shhoel/FPGA-Real-Time-Background-Subtraction-OV7670-DE2-115/Images/Setup.jpg

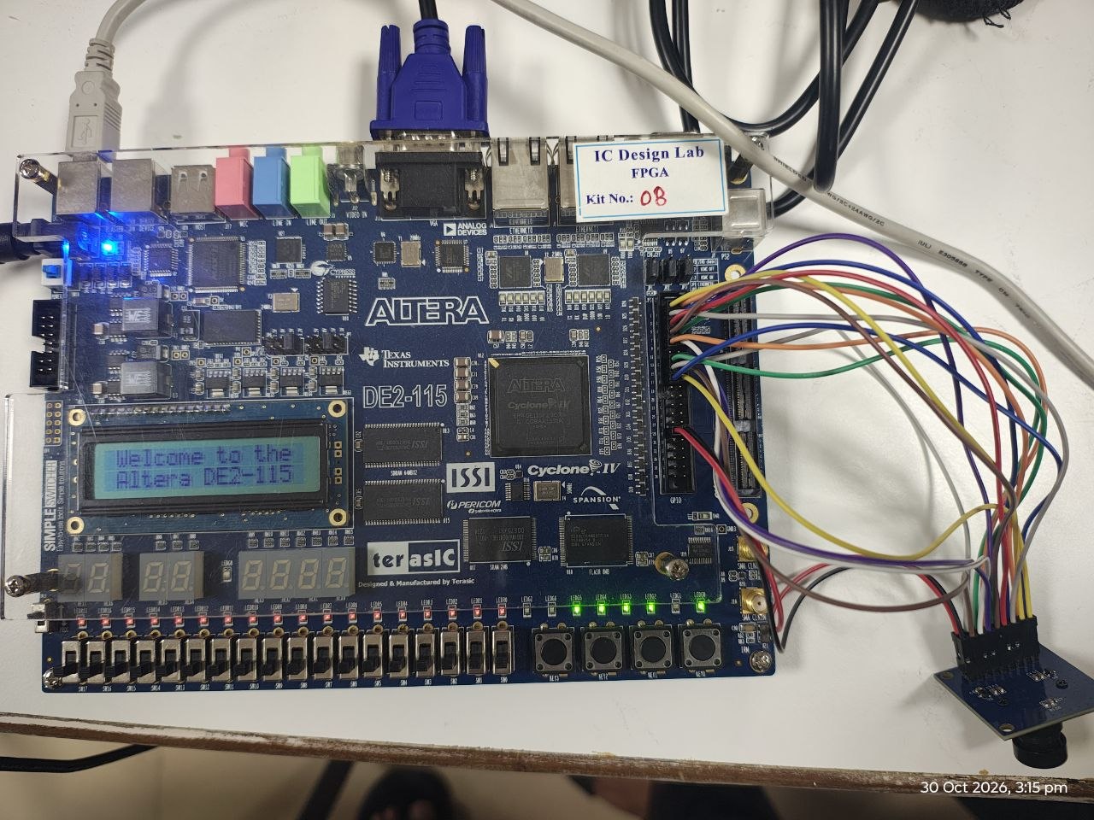
Images/Setup.jpg
