shhoel/FPGA-Real-Time-Background-Subtraction-OV7670-DE2-115/Images/Live Image.jpg

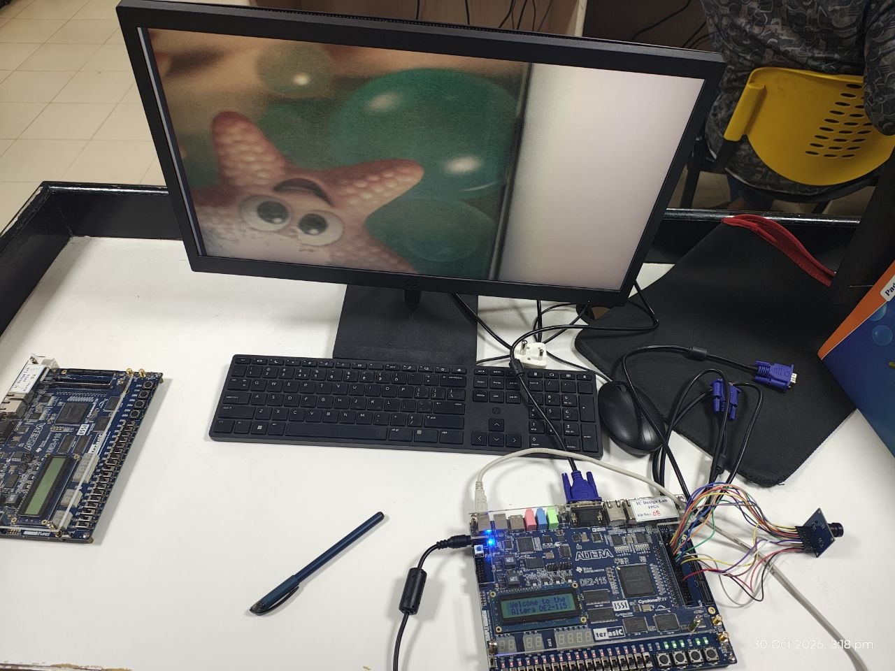
Images/Live Image.jpg
