shhoel/FPGA-Real-Time-Background-Subtraction-OV7670-DE2-115/README.md

# FPGA-Based Real-Time Background Subtraction Using OV7670 and DE2-115

## Overview

This project implements a **real-time video background subtraction system on FPGA** using an **OV7670 camera module**, **Terasic DE2-115 development board**, and **VGA monitor**.

The OV7670 camera provides a live RGB565 video stream. The FPGA captures the camera data, converts RGB565 pixels to RGB444, reduces the image resolution from 640×480 to 320×240, stores both live and reference-background frames, performs pixel-wise foreground detection, removes noise using a 3×3 majority filter, and displays the processed result on a VGA monitor.

The system supports:

- Normal live video
- Background subtraction
- Original-color foreground with black background
- Binary white foreground mask
- Adjustable foreground threshold
- VGA diagnostic color bars
- Camera/debug status LEDs

---

# Hardware Used

- Terasic DE2-115 FPGA Development Board
- Intel/Altera Cyclone IV E FPGA
- FPGA Device: `EP4CE115F29C7`
- OV7670 CMOS Camera Module
- VGA Monitor
- VGA Cable
- Jumper Wires

---

# Software Used

- Intel Quartus Prime
- Verilog HDL

---

# System Flow

```text
OV7670 Camera
      |
      v
Camera Configuration
      |
      v
8-bit Camera Data Capture
      |
      v
Two Bytes Combined
      |
      v
RGB565 Pixel
      |
      v
RGB565 to RGB444 Conversion
      |
      v
640x480 to 320x240 Downsampling
      |
      +----------------------+
      |                      |
      v                      v
Live Frame Buffer      Background Frame Buffer
      |                      |
      +----------+-----------+
                 |
                 v
        Pixel-wise Comparison
                 |
                 v
       Luminance + RGB Difference
                 |
                 v
          Foreground Score
                 |
                 v
             Threshold
                 |
                 v
        Raw Foreground Mask
                 |
                 v
        3x3 Majority Filter
                 |
                 v
         Filtered Mask Buffer
                 |
                 v
          Final Pixel Selection
                 |
                 v
             RGB Module
                 |
                 v
            VGA Monitor
```

---

# Main Modules

## 1. `bg_subtraction_top.v`

This is the **top-level integration module**.

Responsibilities:

- Receives the 50 MHz DE2-115 clock
- Generates a 25 MHz VGA-side clock
- Instantiates all project modules
- Synchronizes push buttons and switches
- Controls OV7670 configuration
- Controls background capture
- Reads live and background pixels
- Calculates luminance and RGB differences
- Generates the foreground score
- Performs threshold comparison
- Selects live video, foreground output, binary mask, or VGA test pattern
- Controls debug LEDs
- Sends the final RGB pixel to the VGA interface

The actual background-subtraction decision is implemented in this module.

---

## 2. `ov7670_controller.v`

This module controls OV7670 initialization.

Responsibilities:

- Generates the camera XCLK
- Keeps the camera powered and out of reset
- Receives camera register commands from `ov7670_registers.v`
- Sends commands through `i2c_sender.v`
- Advances to the next camera register
- Indicates when configuration is complete

The camera XCLK is generated by dividing the 50 MHz input clock by two.

```text
50 MHz / 2 = 25 MHz
```

---

## 3. `ov7670_registers.v`

This module acts like an **internal ROM / lookup table** containing the OV7670 initialization sequence.

Each 16-bit command contains:

```text
[15:8] = OV7670 register address
[7:0]  = value written to the register
```

For example:

```text
16'h4010
```

means:

```text
Register address = 0x40
Register value   = 0x10
```

The register sequence configures:

- Camera reset
- RGB output mode
- RGB565 format
- Clock settings
- Automatic gain control
- Color conversion matrix
- Gamma processing
- Horizontal image window
- Vertical image window
- Mirror/flip configuration

The final working color matrix used in this project is:

```text
4F40
5034
510C
5217
5329
5440
581E
```

---

## 4. `i2c_sender.v`

This module performs SCCB/I²C-like communication with the OV7670 camera.

It sends:

```text
Camera Device Address
Register Address
Register Value
```

using:

```text
SIOC
SIOD
```

The OV7670 write ID used in the controller is:

```text
0x42
```

A simple way to understand the configuration chain is:

```text
ov7670_registers = WHAT to send
i2c_sender       = HOW to send it
ov7670_controller = WHEN to send it
```

---

## 5. `ov7670_capture_bg.v`

This module is responsible for camera pixel capture and background-frame capture.

Responsibilities:

- Samples camera data, HREF and VSYNC on the falling edge of PCLK
- Processes the captured values on the rising edge of PCLK
- Combines two 8-bit camera bytes into one RGB565 pixel
- Supports optional RGB565 byte swapping
- Converts RGB565 to RGB444
- Reduces resolution from 640×480 to 320×240
- Continuously writes the live frame buffer
- Captures one full background frame after KEY1 is pressed
- Generates background busy and background valid status signals

### PCLK Timing Method

Camera signals are sampled on the falling edge:

```text
Falling PCLK
→ sample CAM_D, HREF and VSYNC
```

Then processed on the rising edge:

```text
Rising PCLK
→ assemble and write the pixel
```

This provides approximately half a PCLK period for camera signals to settle and helped remove horizontal tearing in the video.

---

# RGB565 to RGB444 Conversion

The OV7670 produces RGB565:

```text
RRRRR GGGGGG BBBBB
```

This uses:

```text
Red   = 5 bits
Green = 6 bits
Blue  = 5 bits
Total = 16 bits
```

The project converts this to RGB444:

```text
RRRR GGGG BBBB
```

which uses:

```text
Red   = 4 bits
Green = 4 bits
Blue  = 4 bits
Total = 12 bits
```

The conversion used in the capture module is:

```verilog
wire [11:0] pixel444 = {
    pixel565[15:12],
    pixel565[10:7],
    pixel565[4:1]
};
```

### Why RGB444?

RGB444 is used because:

- It reduces frame-buffer memory usage
- It simplifies arithmetic
- Background subtraction does not require full RGB565 precision
- All three color channels have equal 4-bit widths

For one 320×240 frame:

```text
320 × 240 = 76,800 pixels
```

RGB565 memory:

```text
76,800 × 16 = 1,228,800 bits
```

RGB444 memory:

```text
76,800 × 12 = 921,600 bits
```

Therefore RGB444 saves approximately 25% of pixel-storage memory.

---

# Resolution Reduction

The incoming camera frame is:

```text
640 × 480
```

The FPGA stores and processes:

```text
320 × 240
```

This is called:

**2× spatial downsampling**

or

**VGA to QVGA resolution reduction**

The capture module keeps:

- Every second pixel horizontally
- Every second input line vertically

The relevant condition is:

```verilog
if (!x_pixel[0] && !y_line[0])
```

This means only even x and even y positions are stored.

Therefore:

```text
640 / 2 = 320
480 / 2 = 240
```

The number of pixels reduces from:

```text
640 × 480 = 307,200 pixels
```

to:

```text
320 × 240 = 76,800 pixels
```

This reduces the number of stored and processed pixels by a factor of four.

---

# Frame Buffers

Two RGB444 frame buffers are used.

## Live Frame Buffer

The live frame buffer is continuously updated with the newest camera frame.

It does not store every video frame permanently.

At every new frame:

```text
write address resets to 0
```

and the new frame overwrites the previous frame.

Therefore memory usage remains constant.

---

## Background Frame Buffer

The background frame buffer stores one fixed reference frame.

When `KEY1` is pressed:

```text
Background request
→ wait for next VSYNC
→ capture one complete frame
→ store it as background
```

The stored background remains unchanged until another background capture is requested.

---

# Frame Buffer Size

Resolution:

```text
320 × 240
```

Total locations:

```text
76,800
```

Each RGB444 pixel:

```text
12 bits
```

The frame-buffer address uses:

```text
17 bits
```

because:

```text
2^16 = 65,536  -> not enough

2^17 = 131,072 -> enough
```

---

# VGA Timing

The `vga_timing.v` module generates approximately:

```text
640 × 480 @ 60 Hz
```

using a 25 MHz pixel clock.

Horizontal timing:

```text
Active      = 640
Front Porch = 16
Sync        = 96
Back Porch  = 48
Total       = 800
```

Vertical timing:

```text
Active      = 480
Front Porch = 10
Sync        = 2
Back Porch  = 33
Total       = 525
```

---

# 320×240 to 640×480 Display

The stored video is 320×240 but the VGA display is 640×480.

The source coordinates are calculated using:

```verilog
wire [8:0] xs = h[9:1];
wire [7:0] ys = v[8:1];
```

This is equivalent to:

```text
source_x = VGA_x / 2
source_y = VGA_y / 2
```

Therefore each source pixel is displayed as a 2×2 VGA block.

---

# Frame Buffer Address Calculation

The RAM address is:

```text
address = y × 320 + x
```

Instead of using a multiplier:

```text
320 = 256 + 64
```

Therefore:

```text
y × 320
=
(y << 8) + (y << 6)
```

The code uses shift/concatenation and addition to implement this efficiently.

---

# Background Subtraction Algorithm

Each live RGB444 pixel is separated into:

```text
Rlive
Glive
Blive
```

The corresponding background pixel is separated into:

```text
Rbackground
Gbackground
Bbackground
```

---

## Luminance Calculation

A grayscale-like luminance value is calculated as:

```text
Y = (R + 2G + B) / 4
```

This does not convert the displayed image to grayscale.

The image remains RGB.

The luminance is only used internally for foreground detection.

---

## Difference Calculation

The FPGA calculates:

```text
dy = |Ylive - Ybackground|

dr = |Rlive - Rbackground|

dg = |Glive - Gbackground|

db = |Blive - Bbackground|
```

Then:

```text
max_rgb = max(dr, dg, db)
```

---

# Foreground Score

The foreground score is:

```text
foreground_score = 2 × dy + max_rgb
```

This gives more importance to luminance change while still considering color change.

---

# Threshold

The pixel is classified as foreground when:

```text
foreground_score > threshold
```

The final default threshold is:

```text
3
```

when:

```text
SW8:SW3 = 000000
```

If `SW8:SW3` is non-zero, the switch value becomes the threshold.

### Threshold Effect

Lower threshold:

```text
More sensitive
More foreground detected
More possible noise
```

Higher threshold:

```text
Less sensitive
Cleaner background
Possible loss of foreground regions
```

---

# Raw Foreground Mask

After thresholding:

```text
1 = foreground
0 = background
```

This produces a 1-bit binary mask called:

```text
foreground_raw
```

---

# 3×3 Majority Filter

The raw foreground mask may contain isolated noisy pixels.

The `mask_filter_3x3.v` module examines a 3×3 neighborhood:

```text
P1 P2 P3
P4 P5 P6
P7 P8 P9
```

The number of foreground pixels is counted.

The final implementation uses:

```text
4-out-of-9 majority rule
```

If at least four pixels are foreground:

```text
output = foreground
```

otherwise:

```text
output = background
```

The final code uses:

```verilog
out_mask <= (ones >= 4'd4);
```

This removes isolated noise while preserving foreground regions better than a stricter 5-out-of-9 rule.

---

# Mask Buffer

The filtered mask is stored in `mask_buffer.v`.

Each location requires only:

```text
1 bit
```

because:

```text
0 = background
1 = foreground
```

Mask resolution:

```text
320 × 240
```

---

# Final Pixel Selection

The final video output depends on the switches.

## Normal Video

```text
SW0 = 0
```

Output:

```text
Live camera image
```

---

## Background Subtraction

```text
SW0 = 1
```

and a valid background must already exist.

Background pixels are output as:

```text
RGB444 = 12'h000
```

which is black.

---

## Original-Color Foreground

```text
SW0 = 1
SW1 = 0
```

Output:

```text
Foreground = original RGB color
Background = black
```

---

## Binary Mask

```text
SW0 = 1
SW1 = 1
```

Output:

```text
Foreground = white
Background = black
```

White is:

```text
12'hFFF
```

---

# VGA Test Pattern

```text
SW2 = 1
```

enables an internally generated VGA color-bar test pattern.

This allows the VGA output path to be tested independently of the camera.

The pattern includes:

- White
- Yellow
- Cyan
- Green
- Magenta
- Red
- Blue
- Gray

---

# RGB Output Module

The internal pixel format is RGB444:

```text
12 bits
```

The DE2-115 VGA interface uses:

```text
8 bits Red
8 bits Green
8 bits Blue
```

The `RGB.v` module expands each 4-bit color channel by repeating the nibble.

Example:

```text
4'b1010
```

becomes:

```text
8'b10101010
```

During VGA blanking:

```text
R = 0
G = 0
B = 0
```

---

# Camera Connections

## OV7670 to DE2-115 JP5

| OV7670 Pin | Function | JP5 Physical Pin | FPGA Pin |
|---|---|---:|---|
| D0 | Camera data bit 0 | 1 | AB22 |
| D1 | Camera data bit 1 | 2 | AC15 |
| D2 | Camera data bit 2 | 3 | AB21 |
| D3 | Camera data bit 3 | 4 | Y17 |
| D4 | Camera data bit 4 | 5 | AC21 |
| D5 | Camera data bit 5 | 6 | Y16 |
| D6 | Camera data bit 6 | 7 | AD21 |
| D7 | Camera data bit 7 | 8 | AE16 |
| PCLK | Pixel clock | 9 | AD15 |
| HREF | Horizontal reference | 10 | AE15 |
| VSYNC | Frame synchronization | 13 | AC19 |
| XCLK | Camera input clock | 14 | AF16 |
| SIOC / SCL | SCCB clock | 15 | AD19 |
| SIOD / SDA | SCCB data | 16 | AF15 |
| RESET | Camera reset | 17 | AF24 |
| PWDN | Camera power-down | 18 | AE21 |
| 3.3 V | Camera supply | 29 | Power |
| GND | Ground | 30 | Ground |

**Important:** The OV7670 module is powered using 3.3 V.

---

# Camera Signal Directions

Camera to FPGA:

```text
D0-D7
PCLK
HREF
VSYNC
```

FPGA to camera:

```text
XCLK
SIOC
RESET
PWDN
```

Bidirectional:

```text
SIOD
```

---

# Push Buttons

| Button | Function |
|---|---|
| KEY0 | Reset/reconfigure the OV7670 |
| KEY1 | Capture a new reference background |

---

# Switch Functions

| Switch | Function |
|---|---|
| SW0 | Background subtraction enable |
| SW1 | Original-color / white-mask selection |
| SW2 | VGA test-pattern enable |
| SW8:SW3 | Foreground threshold |
| SW9 | RGB565 byte-order selection |

Final recommended setup:

```text
SW9 = 0
SW8:SW3 = 000000
```

which uses the default threshold of 3.

---

# Debug LEDs

| LED | Function |
|---|---|
| LEDG0 | OV7670 configuration complete |
| LEDG1 | Valid background stored |
| LEDG2 | PCLK activity |
| LEDG3 | HREF activity |
| LEDG4 | VSYNC activity |
| LEDG5 | Camera data activity |
| LEDG6 | Background capture busy |
| LEDG7 | Background subtraction active |
| LEDG8 | Alternate RGB565 byte order selected |

---

# `sig_activity.v`

Camera timing signals change too quickly to observe directly on LEDs.

The `sig_activity` module:

1. Synchronizes the asynchronous signal
2. Detects a transition
3. Loads a hold counter
4. Keeps the LED ON for approximately 0.17 seconds

This allows fast camera signals to be visually checked.

---

# Bit Widths Used

| Signal / Data | Width | Reason |
|---|---:|---|
| `CAM_D` | 8 bits | OV7670 parallel data bus |
| RGB565 | 16 bits | 5R + 6G + 5B |
| RGB444 | 12 bits | 4R + 4G + 4B |
| Frame address | 17 bits | Required for 76,800 locations |
| Internal R/G/B | 4 bits each | RGB444 format |
| `src_x` | 9 bits | Must represent 0–319 |
| `src_y` | 8 bits | Must represent 0–239 |
| Luminance sum | 6 bits | Maximum value is 60 |
| RGB differences | 5 bits | Safe subtraction width |
| Foreground score | 7 bits | Prevents overflow during weighted addition |
| Threshold | 6 bits | Comes from six switches |
| Foreground mask | 1 bit | Foreground/background only |
| VGA R/G/B | 8 bits each | DE2-115 VGA interface |

---

# How to Run

1. Connect the OV7670 camera to JP5 using the pin mapping above.
2. Connect the DE2-115 board to a VGA monitor.
3. Open the Quartus project.
4. Select the device:

```text
EP4CE115F29C7
```

5. Compile the project.
6. Program the DE2-115 FPGA.
7. Set:

```text
SW9 = 0
SW8:SW3 = 000000
SW2 = 0
SW1 = 0
SW0 = 0
```

8. Verify that the normal camera image is visible.
9. Keep the camera stationary.
10. Ensure no foreground object/person is present.
11. Wait a few seconds for camera exposure to stabilize.
12. Press `KEY1` once.
13. Verify that `LEDG1` indicates a valid background.
14. Enter the camera view.
15. Set:

```text
SW0 = 1
```

16. The unchanged background should become black.
17. Foreground objects should remain visible.
18. Set:

```text
SW1 = 1
```

to display the binary white foreground mask.

---

# VGA Test Procedure

To test the VGA interface independently:

```text
SW2 = 1
```

The monitor should display the internal color-bar pattern.

Then return:

```text
SW2 = 0
```

to display camera video.

---

# Final Configuration

The final tested foreground detector uses:

```text
Default threshold = 3
3×3 filter        = 4-of-9
RGB byte swap     = disabled
SW9               = 0
```

---

# Results

The final FPGA implementation successfully performs:

- OV7670 camera initialization
- Stable real-time camera capture
- RGB565 to RGB444 conversion
- 640×480 to 320×240 downsampling
- Live-frame storage
- Reference-background capture
- Pixel-wise foreground detection
- Luminance and RGB-based comparison
- Adjustable thresholding
- 3×3 majority filtering
- Original-color foreground display
- Binary foreground mask display
- 640×480 VGA output
- Camera signal debugging through LEDs

---

# Limitations

The current system uses a fixed reference background.

Therefore:

- The camera must remain stationary after background capture.
- Large lighting changes may create false foreground detections.
- Shadows may be classified as foreground.
- Moved background objects may appear as foreground.
- Camera auto-exposure or white-balance changes may introduce noise.
- The system detects changed regions and does not specifically identify humans.

---

# Applications

Possible applications include:

- Video surveillance
- Motion detection
- Intrusion detection
- Human-presence detection
- Traffic monitoring
- Industrial monitoring
- Foreground extraction
- Preprocessing for object tracking
- Embedded real-time computer vision

---

# Future Improvements

Possible future enhancements include:

- Adaptive background modeling
- Automatic background updating
- Shadow removal
- Morphological opening and closing
- Connected-component analysis
- Bounding-box generation
- Object tracking
- Person detection/classification
- External SDRAM frame buffers
- Higher-resolution video processing
- HDMI output

---

# Project Summary

The complete processing sequence is:

```text
Configure Camera
      ↓
Capture Camera Bytes
      ↓
Combine to RGB565
      ↓
Convert to RGB444
      ↓
Downsample 640×480 to 320×240
      ↓
Store Live and Background Frames
      ↓
Read Corresponding Pixels
      ↓
Calculate Luminance and RGB Differences
      ↓
Calculate Foreground Score
      ↓
Threshold
      ↓
Generate Raw Mask
      ↓
3×3 Majority Filter
      ↓
Store Filtered Mask
      ↓
Select Original Color / White Mask
      ↓
Convert RGB444 to VGA Output
      ↓
Display on Monitor
```

---

# License

This project is released under the **MIT License**.

See the `LICENSE` file for details.
