shhoel/FPGA-Real-Time-Background-Subtraction-OV7670-DE2-115/Images/Background Subtracted.jpg

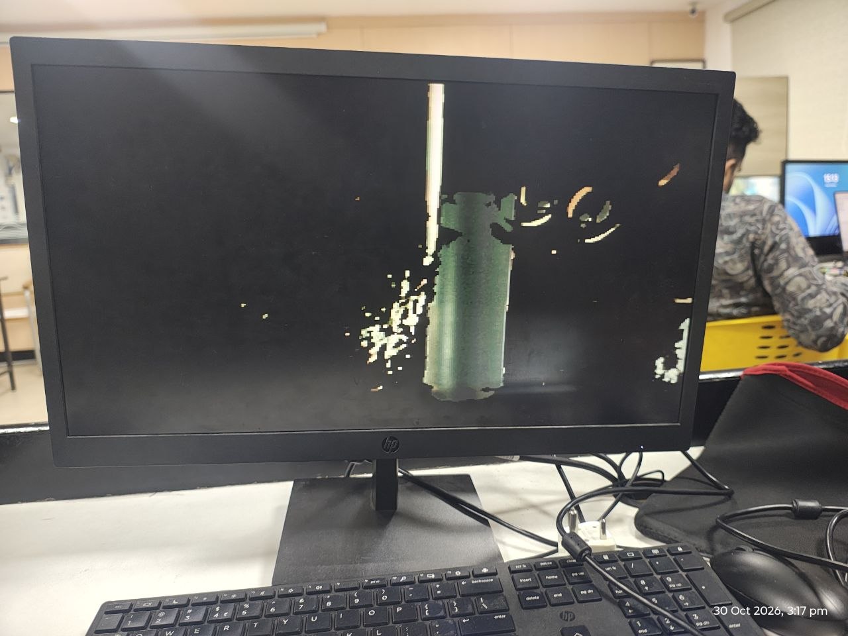
Images/Background Subtracted.jpg
