shhoel/FPGA-Real-Time-Background-Subtraction-OV7670-DE2-115/ov7670_controller.v

// Controller for the OV7670 camera - transfers registers to the
// camera over an I2C like bus (SCCB).
// FIXED: named port connections for i2c_sender (removed stray trailing comma).

module ov7670_controller (
    input  wire  clk,
    input  wire  resend,
    output wire  config_finished,
    output wire  sioc,
    inout  wire  siod,
    output wire  reset,
    output wire  pwdn,
    output wire  xclk
);

    reg         sys_clk = 1'b0;
    wire [15:0] command;
    wire        finished;
    wire        taken;
    wire        send;

    // Device write ID (0x42); see datasheet of camera module
    localparam [7:0] CAMERA_ADDRESS = 8'h42;

    assign config_finished = finished;
    assign send            = ~finished;
    assign reset           = 1'b1;     // Normal mode
    assign pwdn            = 1'b0;     // Power device up
    assign xclk            = sys_clk;  // clk/2 = 25 MHz for a 50 MHz clk

    i2c_sender Inst_i2c_sender (
        .clk      (clk),
        .siod     (siod),
        .sioc     (sioc),
        .taken    (taken),
        .send     (send),
        .id       (CAMERA_ADDRESS),
        .reg_addr (command[15:8]),
        .value    (command[7:0])
    );

    ov7670_registers Inst_ov7670_registers (
        .clk      (clk),
        .advance  (taken),
        .command  (command),
        .finished (finished),
        .resend   (resend)
    );

    always @(posedge clk) begin
        sys_clk <= ~sys_clk;
    end

endmodule
